Shayshez/1uO_c-4ROBOTS/README.md

# 1uO_c-4ROBOTS
1u Ornament and Crime for Intellijel 1u format

Firmware with VOR Support Available here:

https://www.plum-audio.com/firmwares
