Shayshez/1uO_c-4ROBOTS/BOM.xlsx

Sheet: MAIN BOARD
Qty | Value | Device | Package | Parts | Mouser part# | Description | ARROW_PART_NUMBER | ARROW_PRICE-STOCK | AVAILABILITY | DESCRIPTION | HEIGHT | MANUFACTURER_NAME | MANUFACTURER_PART_NUMBER | MF | MP | MPN | PACKAGE | PRICE | RS_PART_NUMBER | RS_PRICE-STOCK | SPICEPREFIX | VALUE | WE-NUMBER
 | Resistors
6 | 100R | R-EU_R0603 | R0603 | R1, R4, R8, R15, R42, R43 | 71-CRCW0603100RFKEAC | RESISTOR, European symbol |  |  |  |  |  |  |  |  |  |  |  |  |  |  | R
4 | 220R | R-EU_R0603 | R0603 | R33, R35, R36, R38 | 279-CRGCQ0603F220R | RESISTOR, European symbol |  |  |  |  |  |  |  |  |  |  |  |  |  |  | R
1 | 2K | R-EU_R0603 | R0603 | R25 | 652-CR0603-FX2001EPF | RESISTOR, European symbol |  |  |  |  |  |  |  |  |  |  |  |  |  |  | R
2 | 10k | R-EU_R0603 | R0603 | R40, R41 | 279-CRGP0603F10K | RESISTOR, European symbol |  |  |  |  |  |  |  |  |  |  |  |  |  |  | R
4 | 24K | R-EU_R0603 | R0603 | R26, R27, R28, R29 | 667-ERJ-3EKF2402V | RESISTOR, European symbol |  |  |  |  |  |  |  |  |  |  |  |  |  |  | R
8 | 33K | R-EU_R0603 | R0603 | R2, R5, R11, R14, R18, R19, R21, R24 | 755-SFR03EZPF3302 | RESISTOR, European symbol |  |  |  |  |  |  |  |  |  |  |  |  |  |  | R
5 | 75K | R-EU_R0603 | R0603 | R6, R9, R12, R16, R31 | 667-ERJ-3EKF7502V | RESISTOR, European symbol |  |  |  |  |  |  |  |  |  |  |  |  |  |  | R
13 | 100K | R-EU_R0603 | R0603 | R3, R7, R10, R13, R17, R20, R22, R23, R30 R32,, R34, R37, R39 | 71-CRCW0603100KFKEAC | RESISTOR, European symbol |  |  |  |  |  |  |  |  |  |  |  |  |  |  | R
 | Caps 0603 >25V
4 | 22p C0G | C-EUC0603 | C0603 | C24, C25, C28, C30 | 581-06035A220JAT4A | CAPACITOR, European symbol
4 | 560p C0G | C-EUC0603 | C0603 | C1, C2, C4, C6 | 581-06035A561JAT4A | CAPACITOR, European symbol
13 | 100n | C-EUC0603 | C0603 | C3, C5, C9, C10, C16, C17, C21, C22, C23, C26, C27, C29, C31 | 80-C0603C104Z3V | CAPACITOR, European symbol
1 | 470n | C-EUC0603 | C0603 | C15 | 963-UMK107B7474KA-TR | CAPACITOR, European symbol
2 | 1uF | C-EUC0603 | C0603 | C11, C14 | 810-CGA3E1X7R1E105K | CAPACITOR, European symbol
1 | 10uF > 10V | C-EUC0603 | C0603 | C20 | 81-GRM188R61E106KA3J | CAPACITOR, European symbol
 | Caps 1206
2 | 10uF | C-EUC1206K | C1206K | C7, C8 | 963-TMK316BJ106KL-T | CAPACITOR, European symbol
 | Caps electrolytic
2 | 10uF | CPOL-EUB | PANASONIC_B | C12, C13 | 667-EEE-FK1H100SR | POLARIZED CAPACITOR, European symbol |  |  |  |  |  |  |  |  |  |  |  |  |  |  | C
1 | 10uF | CPOL-USA | PANASONIC_A | C40 | 598-AVE106M16A12T-F | POLARIZED CAPACITOR, American symbol
2 | 22uF | CPOL-EUC | PANASONIC_C | C18, C19 | 667-EEE-FK1H220SR | POLARIZED CAPACITOR, European symbol |  |  |  |  |  |  |  |  |  |  |  |  |  |  | C
 | Inductor
1 | 10uH | WE-LQ_1210_744032001 | WE-LQ_M | L1 | 963-LB3218T100K | SMD Inductor |  |  |  |  |  |  |  |  |  |  |  |  |  |  |  |  | 744032001/1uH
 | IC's
2 | 1N5819HW | DIODE_DIODE-SOD123 | DIODE_SOD123 | D1, D2 | 621-1N5819HW-F | DIODE
1 | ADP150AUJZ-3.3-R7 | ADP150AUJZ-3.3-R7 | SOT95P280X100-5N | U1 | 584-ADP150AUJZ-3.3R7 | IC REG LINEAR 2V 150MA 5TSOT |  |  | Good | LDO Regulator Pos 2V 0.15A 5-Pin TSOT T/R |  |  |  | Analog Devices | ADP150AUJZ-2.0-R7 |  | TSOT-23 Analog Devices | 0.65 USD
1 | DAC8565IAPW | DAC8565IAPW | SOP65P640X120-16N | U3 | 595-DAC8565IAPW | Quad Channel DAC |  |  | Good | 16-Bit, Quad Channel, Ultra-Low Glitch, Voltage Output DAC with 2.5V, 2ppm/C Internal eference 16-TSSOP -40 to 105 |  |  |  | Texas Instruments | DAC8565IAPW |  | TSSOP-16 Texas Instruments | 10.78 USD
1 | LD1117S50TR | LD1117S50TR | SOT223 | U2 | 511-LD1117S50 | http://octopart.com/ld1117s50tr-stmicroelectronics-529395 |  |  | Good | LD1117 Series 1300 mA 5 V Fixed Output Positive Voltage LDO Regulator - SOT-223 |  |  |  | STMicroelectronics | LD1117S50TR |  | SOT-223 STMicroelectronics | 0.19 USD
1 | LM321MF | LM321MF | SOT23-5 | IC7 | 926-LM321MF | Low Power Single Op Amp
1 | LM4040-5V | LM4041B12DBZ | DBZ_R-PDSO-G3 | IC3 | 926-LM4040DIM350NOPB | PRECISION MICROPOWER SHUNT VOLTAGE REFERENCE
2 | MCP6002SMT | MCP6002SMT | SOIC8 | IC1, IC2 | 579-MCP6002T-I/SN | Dual General Op Amp
1 | MIC803-46D2VM3TR | MIC803-46D2VM3TR | SOT95P230X110-3N | IC4 | 998-MIC803-26D2VM3TR | 3-pin Microprocessor Supervosor Circui | MIC803-46D2VM3TR |  |  | 3-pin Microprocessor Supervosor Circui | mm | Micrel | MIC803-46D2VM3TR
4 | MMBT3904LT1G | SMD-TRANSISTORS-NPN-40V-200MA-MMBT3904LT1G(SOT-23) | SOT-23 | Q1, Q2, Q3, Q4 | 863-MMBT3904LT1G | 305010013 |  |  |  |  |  |  |  |  |  | MMBT3904LT1G |  |  |  |  |  | MMBT3904LT1G
2 | TL072D | TL072D | SO08 | IC5, IC6 | 595-TL072CDR | OP AMP
1 | TEENSY_3.2_TEMPS_NO29 | TEENSY_3.2_TEMPS_NO29 | TEENSY_3.2_TEMPS_NO29 | TEENSY | 474-DEV-13736
 | PIN HEADERS MALE
1 | POWER Header | PINHD-2X5 | 2X5 | Power
1 |  | PINHD-2X5 | 2X5 | J3 |  | WR-PHD 2.54mm Dual Pin Header, 10 Pins =>Code : Con_BTB_PHD_2.54_2_61301021121
3 |  | PINHD-1X4 | 1X04 | J2, J4, J5 |  | PIN HEADER
1 |  | PINHD-1X8 | 1X08 | J1 |  | PIN HEADER

Sheet: UI BOARD
Qty | Value | Device | Package | Parts |  | Description | SPICEPREFIX
 | Resistor 0603
2 | 510R | R-EU_R0603 | R0603 | R100, R101 | 603-RC0603FR-07510RL | RESISTOR, European symbol | R
1 | 10k | R-EU_R0603 | R0603 | R102 | 279-CRGP0603F10K | RESISTOR, European symbol | R
 | Caps 0603
3 | 100n | C-EUC0603 | C0603 | C101, C103, C104 | 80-C0603C104Z3V | CAPACITOR, European symbol
2 | 470n | C-EUC0603 | C0603 | C100, C102 | 963-UMK107B7474KA-TR | CAPACITOR, European symbol
 | UI Parts
12 | PJ301_PJ301 (THONKICONN) | PJ301_PJ301 | PJ301_WQP_PJ_301M6 | CV1, CV2, CV3, CV4, CV_A, CV_B, CV_C, CV_D, TR1, TR2, TR3, TR4 | Thonk
2 | PEC11RPEC11R-SLOTED | PEC11RPEC11R-SLOTED | PEC11R-SLOTED | ENC_L, ENC_R | 858-EN11-HSM1BF20 | Incremental encoder 24 detents 24 pulses Bourns 24 Pulse Incremental Mechanical Rotary Encoder with a 6 mm Flat Shaft (Not Indexed), Through Hole
2 | Tact Switch | TAC_SWITCHPTH | TACTILE-PTH | SW_B, SW_T | 612-TL1105SP-250 | Momentary Switch
2 | Tact Switch CAP |  |  |  | 612-1R-BK
1 | 0.96_OLED_BOARD | 0.96_OLED_BOARD | 0.96_OLED_BOARD | OLED
 | PIN HEADERS FEMALE
1 |  | PINHD-2X5 | 2X5 | J102 |  | WR-PHD 2.54mm Dual Pin Header, 10 Pins =>Code : Con_BTB_PHD_2.54_2_61301021121
3 |  | PINHD-1X4 | 1X04 | J100, J103, J104 |  | PIN HEADER
1 |  | PINHD-1X8 | 1X08 | J101 |  | PIN HEADER

Sheet: 0.96 OLED BOARD
Qty | Value | Device | Package | Parts |  | Description | SPICEPREFIX
 | Resistors 0603
4 | 10K | RESISTOR0603MINI | 0603-MINI | R2, R4, R5, R6 | 279-CRGP0603F10K | Resistors
1 | 390K | RESISTOR0603MINI | 0603-MINI | R3 | 603-RC0603FR-07390KL | Resistors
 | Caps 0603
5 | 2.2uF | CAP_CERAMIC0603MINI | 0603-MINI | C3, C4, C6, C7, C8 | 963-EMK107BJ225MA-T | Ceramic Capacitors
1 | 10uF | CAP_CERAMIC0603MINI | 0603-MINI | C5 | 81-GRM188R61E106KA3J | Ceramic Capacitors
1 | UG-2864HSWEG01 | MICROBUILDER_DISP_OLED_UG-2864HSWEG010.96";MICROBUILDER_UG-2864HSWEG01_0.96IN_WRAPAROUND" | U1 | UG-2864HSWEG01 OLED display
1 |  | HEADER-1X7ROUND | 1X07_ROUND | JP1 |  | PIN HEADER | X
3 | Standoffs spacers 6mm | To support screen
