Shayshez/1uO_c-4ROBOTS/4robots_MAIN_1_1.brd

## EAGLE design 4robots_MAIN_1_1.brd (2019-09-29)

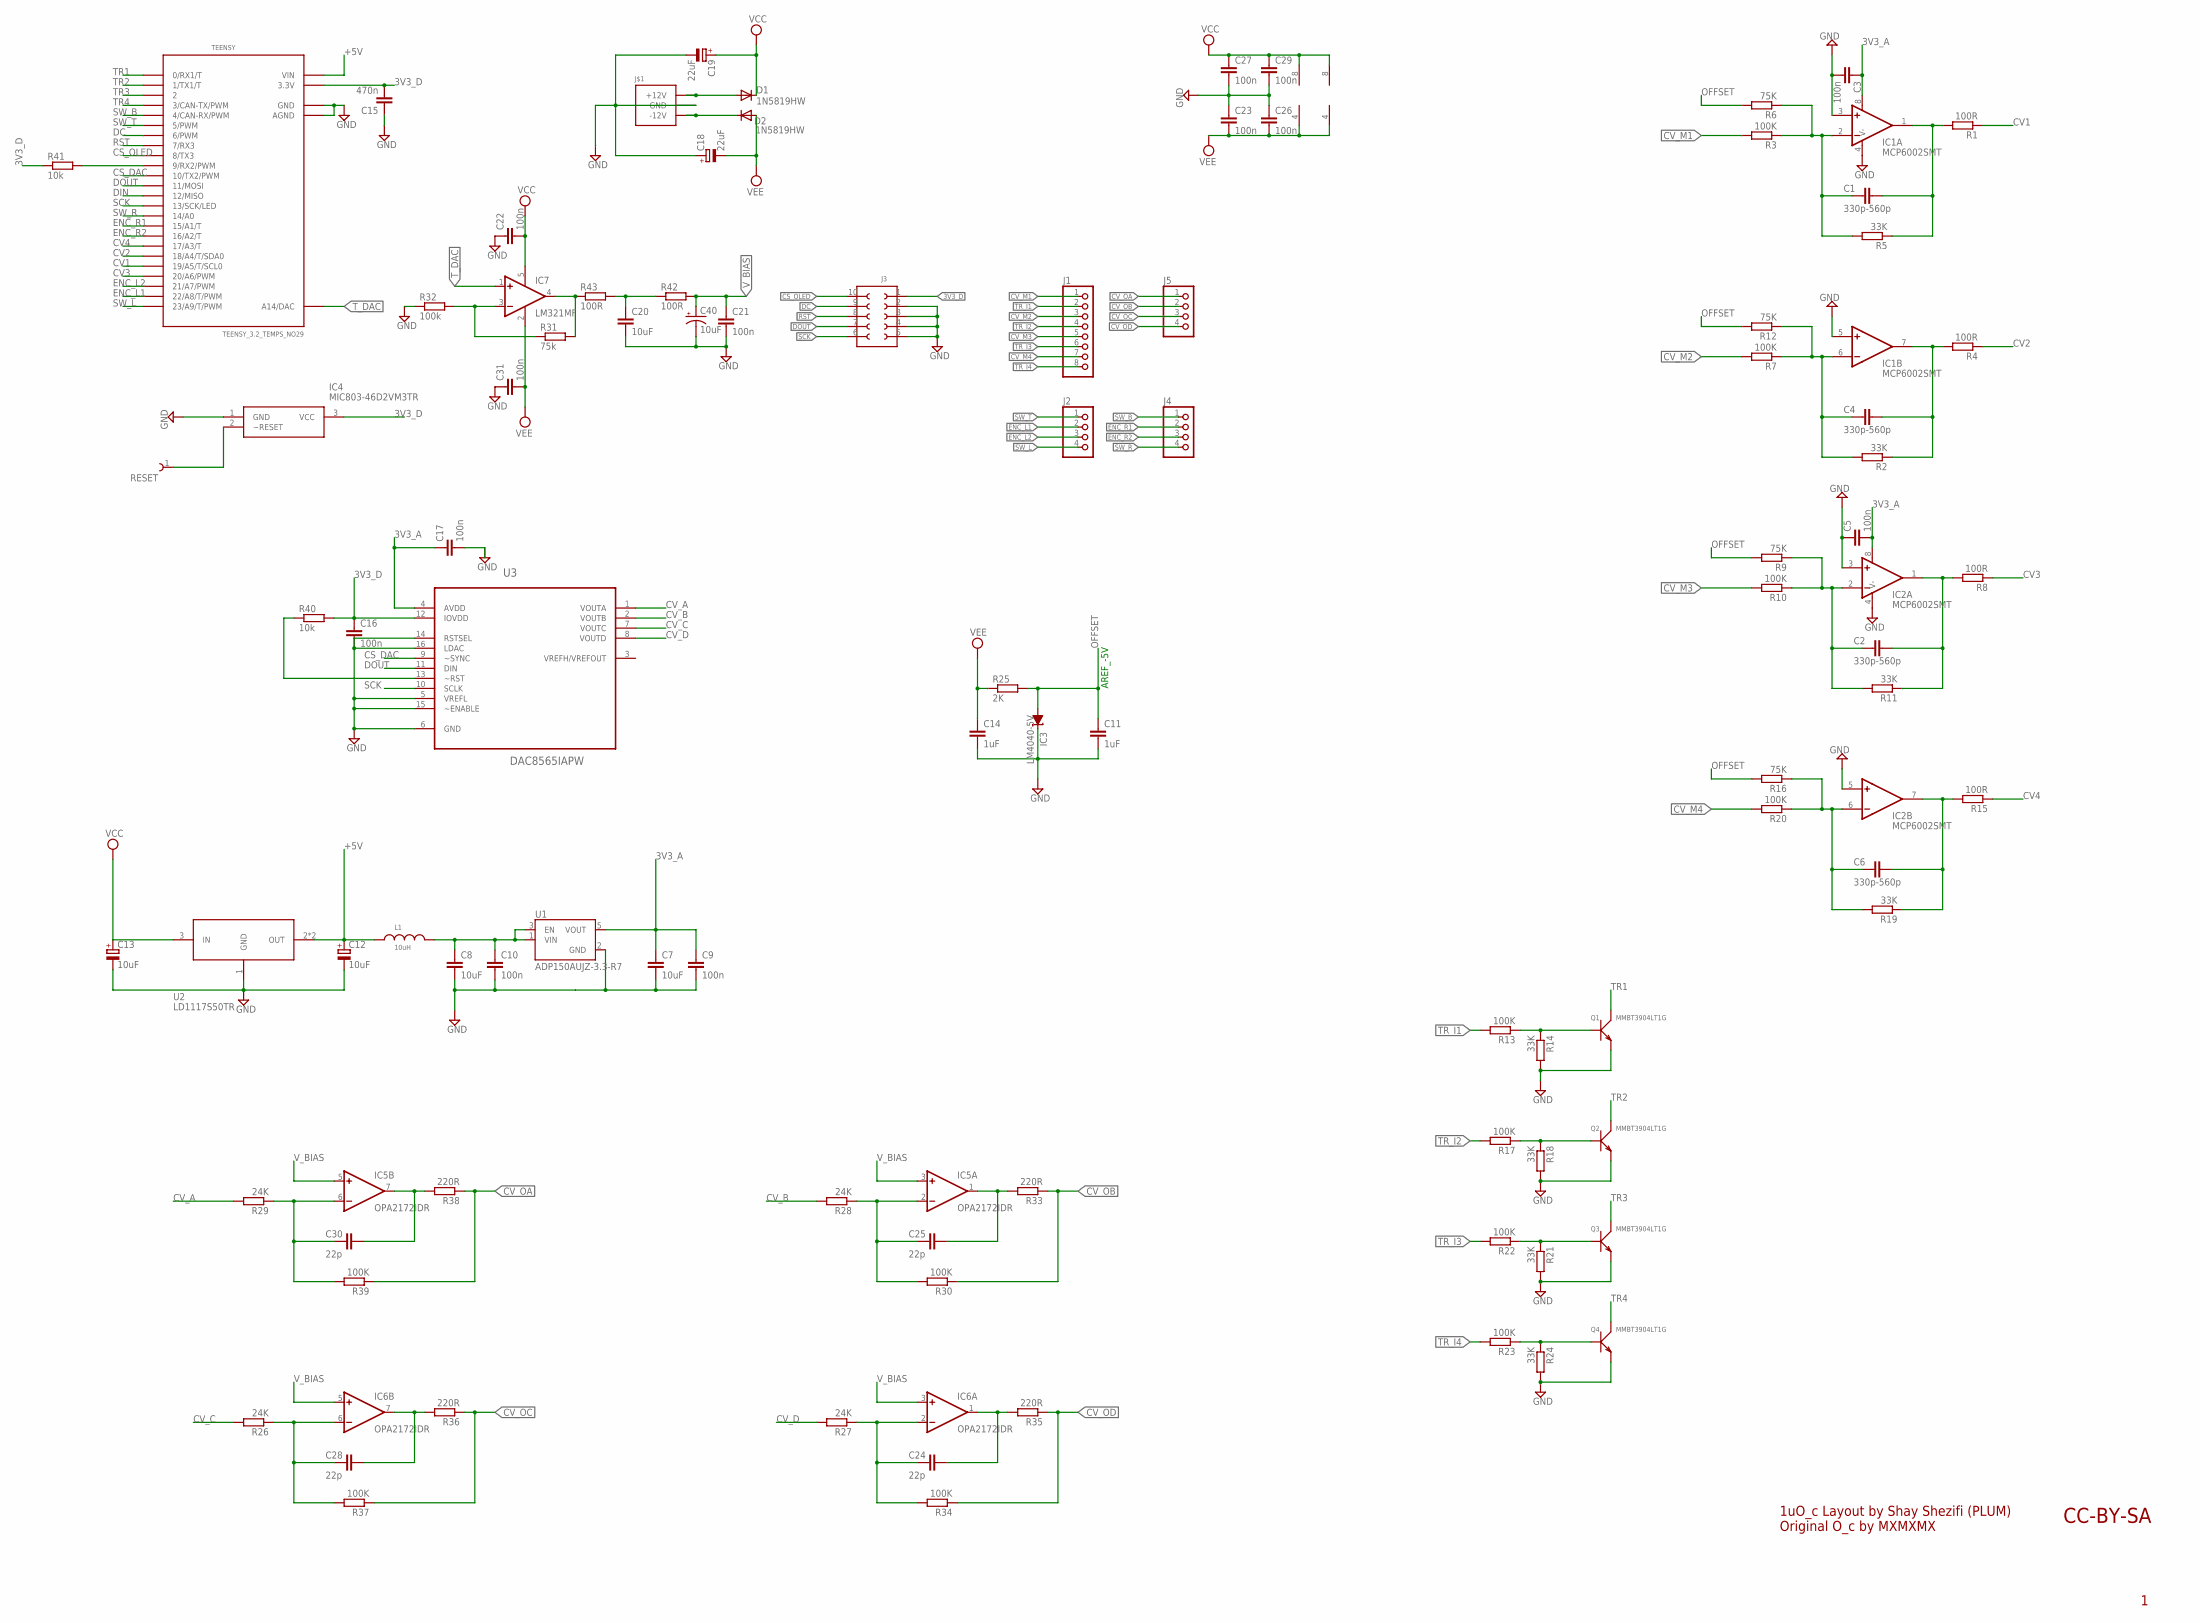
[picture p1: schematic 4robots_MAIN_1_1.sch]

Parts:
C1, C2, C4, C6: 330p-560p; C0603
C3, C5, C9, C10, C16, C17, C21, C22, C23, C26, C27, C29, C31: 100n; C0603
C7, C8: 10uF; C1206K
C11, C14: 1uF; C0603
C12, C13: 10uF; PANASONIC_B
C15: 470n; C0603
C18, C19: 22uF; PANASONIC_C
C20: 10uF; C0603
C24, C25, C28, C30: 22p; C0603
C40: 10uF; PANASONIC_A
D1, D2: 1N5819HW; DIODE_SOD123
IC1, IC2: MCP6002SMT; SOIC8
IC3: LM4040-5V; DBZ_R-PDSO-G3
IC4: MIC803-46D2VM3TR; SOT95P230X110-3N
IC5, IC6: OPA2172IDR; SO08
IC7: LM321MF; SOT23-5
J1: PINHD-1X8; 1X08
J2, J4, J5: PINHD-1X4; 1X04
J3: 61301021121
J$1: POWER_SIMPLE10; POWER_10
L1: 10uH; WE-LQ_M
Q1, Q2, Q3, Q4: MMBT3904LT1G; SOT-23
R1, R4, R8, R15, R42, R43: 100R; R0603
R2, R5, R11, R14, R18, R19, R21, R24: 33K; R0603
R3, R7, R10, R13, R17, R20, R22, R23, R30, R34, R37, R39: 100K; R0603
R6, R9, R12, R16: 75K; R0603
R25: 2K; R0603
R26, R27, R28, R29: 24K; R0603
R31: 75k; R0603
R32: 100k; R0603
R33, R35, R36, R38: 220R; R0603
R40, R41: 10k; R0603
RESET: 61300111121
TEENSY: TEENSY_3.2_TEMPS_NO29
U1: ADP150AUJZ-3.3-R7; SOT95P280X100-5N
U2: LD1117S50TR; SOT223
U3: DAC8565IAPW; SOP65P640X120-16N

Connections:
3V3_A: C3.1, C5.2, C7.1, C9.1, C17.1, IC1.8 (V+), IC2.8 (V+), U1.5 (VOUT), U3.4 (AVDD)
3V3_D: C15.2, C16.1, IC4.3 (VCC), J3.1, R40.2, R41.1, TEENSY.3.3V, U3.12 (IOVDD)
+5V: C12.+, L1.1, TEENSY.VIN, U2.2 (OUT), U2.4 (OUT)
CS_DAC: TEENSY.10 (10/TX2/PWM), U3.9 (~SYNC)
CS_OLED: J3.10, TEENSY.8 (8/TX3)
CV1: R1.1, TEENSY.19/A5 (19/A5/T/SCL0)
CV2: R4.1, TEENSY.18/A4 (18/A4/T/SDA0)
CV3: R8.1, TEENSY.20/A6 (20/A6/PWM)
CV4: R15.1, TEENSY.17/A3 (17/A3/T)
CV_A: R29.2, U3.1 (VOUTA)
CV_B: R28.2, U3.2 (VOUTB)
CV_C: R26.2, U3.7 (VOUTC)
CV_D: R27.2, U3.8 (VOUTD)
CV_M1: J1.1, R3.2
CV_M2: J1.3, R7.2
CV_M3: J1.5, R10.2
CV_M4: J1.7, R20.2
CV_OA: J5.1, R38.1, R39.1
CV_OB: J5.2, R30.1, R33.1
CV_OC: J5.3, R36.1, R37.1
CV_OD: J5.4, R34.1, R35.1
DC: J3.9, TEENSY.6 (6/PWM)
DIN: TEENSY.12 (12/MISO)
DOUT: J3.7, TEENSY.11 (11/MOSI), U3.11 (DIN)
ENC_L1: J2.2, TEENSY.22/A8 (22/A8/T/PWM)
ENC_L2: J2.3, TEENSY.21/A7 (21/A7/PWM)
ENC_R1: J4.2, TEENSY.15/A1 (15/A1/T)
ENC_R2: J4.3, TEENSY.16/A2 (16/A2/T)
GND: C3.2, C5.1, C7.2, C8.2, C9.2, C10.2, C11.2, C12.-, C13.-, C14.2, C15.1, C16.2, C17.2, C18.+, C19.-, C20.2, C21.2, C22.1, C23.1, C26.1, C27.2, C29.2, C31.1, C40.-, IC1.3 (+IN), IC1.4 (V-), IC1.5 (+IN), IC2.3 (+IN), IC2.4 (V-), IC2.5 (+IN), IC3.1 (C), IC4.1 (GND), J3.2, J3.3, J3.4, J3.5, J$1.3 (GND), J$1.4 (GND), J$1.5 (GND), J$1.6 (GND), J$1.7 (GND), J$1.8 (GND), Q1.2 (E), Q2.2 (E), Q3.2 (E), Q4.2 (E), R14.2, R18.2, R21.2, R24.2, R32.1, TEENSY.AGND, TEENSY.GND, U1.2 (GND), U2.1 (GND), U3.5 (VREFL), U3.6 (GND), U3.14 (RSTSEL), U3.15 (~ENABLE), U3.16 (LDAC)
unnamed: D2.C, J$1.1 (-12V), J$1.2 (-12V)
unnamed: D1.A, J$1.9 (+12V), J$1.10 (+12V)
unnamed: C8.1, C10.1, L1.2, U1.1 (VIN), U1.3 (EN)
unnamed: IC7.4 (OUT), R31.2, R43.1
unnamed: C1.2, IC1.2 (-IN), R3.1, R5.2, R6.1
unnamed: C1.1, IC1.1 (OUT), R1.2, R5.1
unnamed: IC7.3 (-IN), R31.1, R32.2
unnamed: R40.1, U3.13 (~RST)
unnamed: R41.2, TEENSY.9 (9/RX2/PWM)
unnamed: C4.2, IC1.6 (-IN), R2.2, R7.1, R12.1
unnamed: C4.1, IC1.7 (OUT), R2.1, R4.2
unnamed: C20.1, R42.1, R43.2
unnamed: C2.2, IC2.2 (-IN), R9.1, R10.1, R11.2
unnamed: C2.1, IC2.1 (OUT), R8.2, R11.1
unnamed: C6.2, IC2.6 (-IN), R16.1, R19.2, R20.1
unnamed: C6.1, IC2.7 (OUT), R15.2, R19.1
unnamed: Q1.1 (B), R13.1, R14.1
unnamed: Q2.1 (B), R17.1, R18.1
unnamed: Q3.1 (B), R21.1, R22.1
unnamed: Q4.1 (B), R23.1, R24.1
unnamed: C25.2, IC5.2 (-IN), R28.1, R30.2
unnamed: C30.2, IC5.6 (-IN), R29.1, R39.2
unnamed: C30.1, IC5.7 (OUT), R38.2
unnamed: C25.1, IC5.1 (OUT), R33.2
unnamed: C28.2, IC6.6 (-IN), R26.1, R37.2
unnamed: C28.1, IC6.7 (OUT), R36.2
unnamed: C24.2, IC6.2 (-IN), R27.1, R34.2
unnamed: C24.1, IC6.1 (OUT), R35.2
unnamed: IC4.2 (~RESET), RESET.1
OFFSET: C11.1, IC3.2 (A), R6.2, R9.2, R12.2, R16.2, R25.2
RST: J3.8, TEENSY.7 (7/RX3)
SCK: J3.6, TEENSY.13 (13/SCK/LED), U3.10 (SCLK)
SW_B: J4.1, TEENSY.4 (4/CAN-RX/PWM)
SW_L: J2.4, TEENSY.23/A9 (23/A9/T/PWM)
SW_R: J4.4, TEENSY.14/A0
SW_T: J2.1, TEENSY.5 (5/PWM)
TR1: Q1.3 (C), TEENSY.0 (0/RX1/T)
TR2: Q2.3 (C), TEENSY.1 (1/TX1/T)
TR3: Q3.3 (C), TEENSY.2
TR4: Q4.3 (C), TEENSY.3 (3/CAN-TX/PWM)
TR_I1: J1.2, R13.2
TR_I2: J1.4, R17.2
TR_I3: J1.6, R22.2
TR_I4: J1.8, R23.2
T_DAC: IC7.1 (+IN), TEENSY.RESET/DAC (A14/DAC)
VCC: C13.+, C19.+, C22.2, C27.1, C29.1, D1.C, IC5.8 (V+), IC6.8 (V+), IC7.5 (V+), U2.3 (IN)
VEE: C14.1, C18.-, C23.2, C26.2, C31.2, D2.A, IC5.4 (V-), IC6.4 (V-), IC7.2 (V-), R25.1
V_BIAS: C21.1, C40.+, IC5.3 (+IN), IC5.5 (+IN), IC6.3 (+IN), IC6.5 (+IN), R42.2

Notes on the sheet:
AREF_-5V
1uO_c Layout by Shay Shezifi (PLUM) Original O_c by MXMXMX
CC-BY-SA

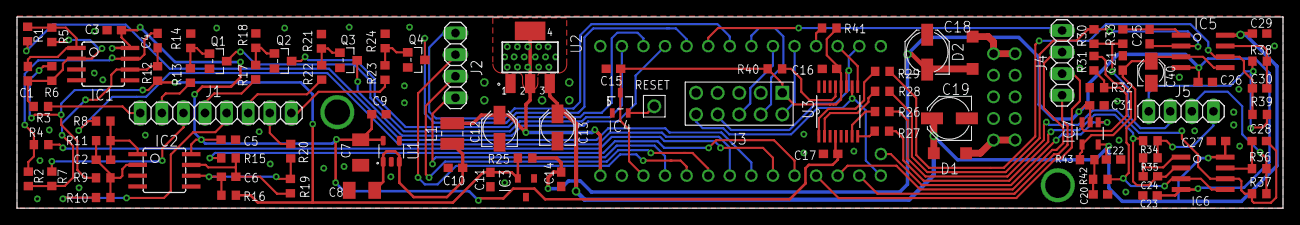
[picture p2: board 4robots_MAIN_1_1.brd from above]

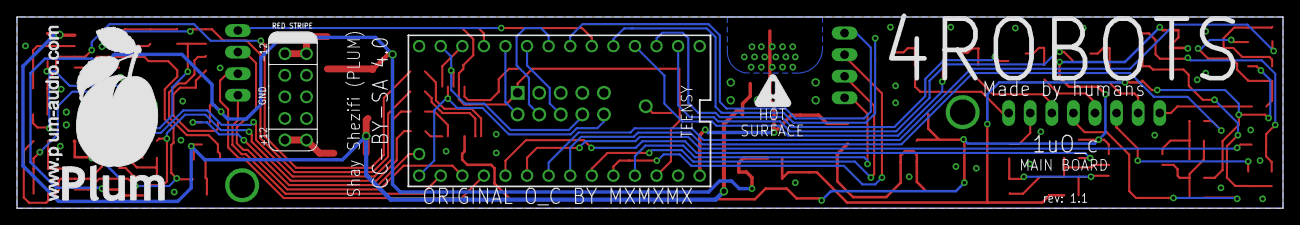
[picture p3: board 4robots_MAIN_1_1.brd from below]

Board: 2 copper layers, 149.0 x 22.5 mm, 100 parts (2 on the bottom side), 76 nets.
