Shayshez/1uO_c-4ROBOTS/0_96_OLED_FOR_1U.brd

## EAGLE design 0_96_OLED_FOR_1U.brd (2019-09-29)

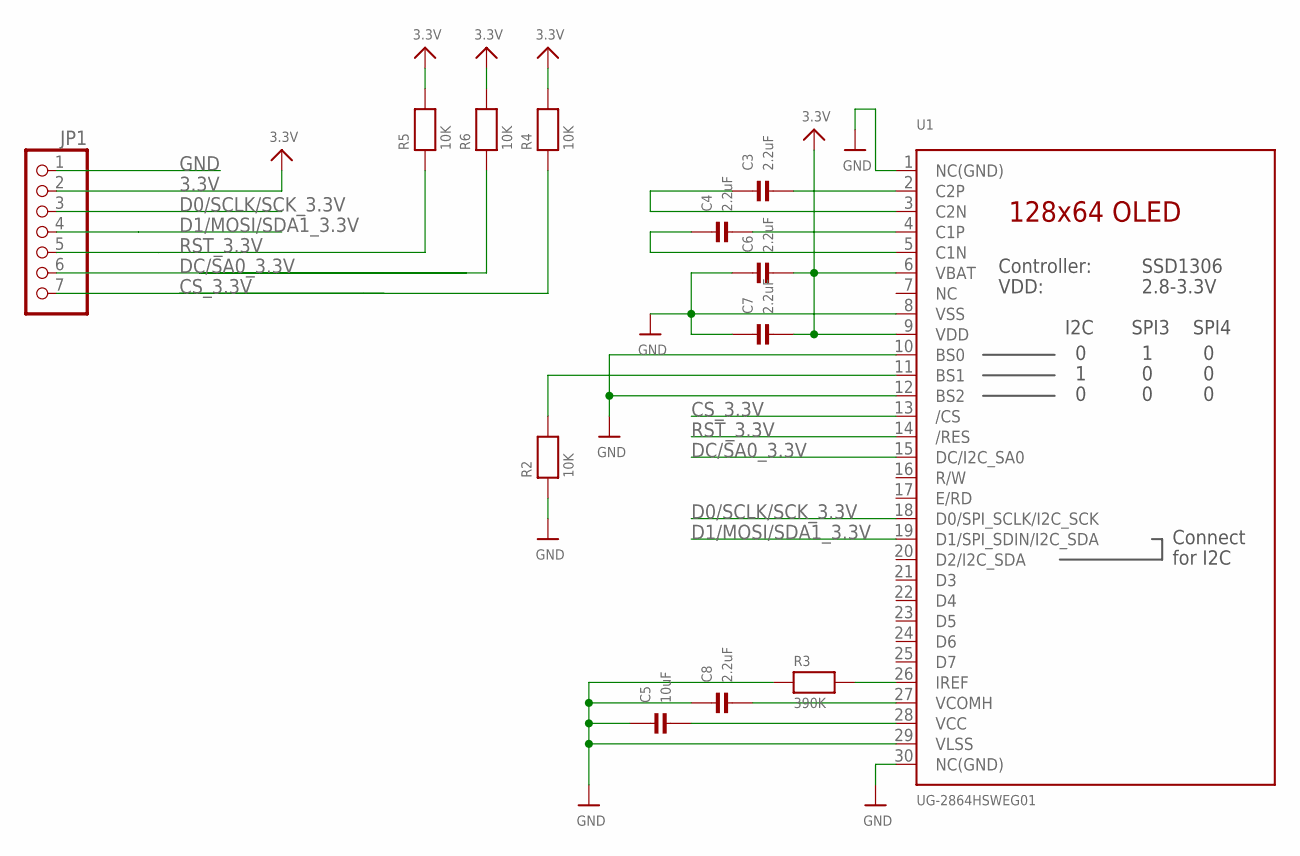
[picture p4: schematic 0_96_OLED_FOR_1U.sch]

Parts:
C3, C4, C6, C7, C8: 2.2uF; 0603-MINI
C5: 10uF; 0603-MINI
JP1: HEADER-1X7ROUND; 1X07_ROUND
R2, R4, R5, R6: 10K; 0603-MINI
R3: 390K; 0603-MINI
U1: UG-2864HSWEG01; MICROBUILDER_UG-2864HSWEG01_0.96IN_WRAPAROUND

Connections:
3.3V: C6.2, C7.2, JP1.2, R4.2, R5.2, R6.2, U1.6 (VBAT), U1.9 (VDD)
CS_3.3V: JP1.7, R4.1, U1.13 (/CS)
D0/SCLK/SCK_3.3V: JP1.3, U1.18 (D0/SPI_SCLK/I2C_SCK)
D1/MOSI/SDA1_3.3V: JP1.4, U1.19 (D1/SPI_SDIN/I2C_SDA)
DC/SA0_3.3V: JP1.6, R6.1, U1.15 (DC/I2C_SA0)
GND: C5.1, C6.1, C7.1, C8.1, JP1.1, R2.1, R3.1, U1.1 (NC(GND)), U1.8 (VSS), U1.10 (BS0), U1.12 (BS2), U1.29 (VLSS), U1.30 (NC(GND))
unnamed: R2.2, U1.11 (BS1)
unnamed: R3.2, U1.26 (IREF)
unnamed: C3.2, U1.2 (C2P)
unnamed: C3.1, U1.3 (C2N)
unnamed: C4.2, U1.4 (C1P)
unnamed: C4.1, U1.5 (C1N)
unnamed: C5.2, U1.28 (VCC)
unnamed: C8.2, U1.27 (VCOMH)
RST_3.3V: JP1.5, R5.1, U1.14 (/RES)

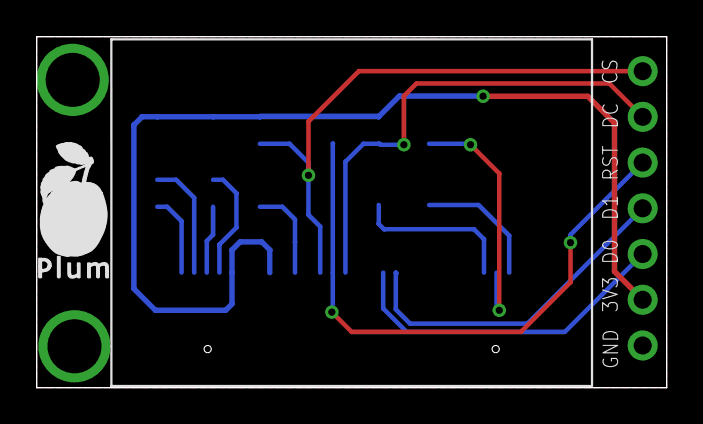
[picture p5: board 0_96_OLED_FOR_1U.brd from above]

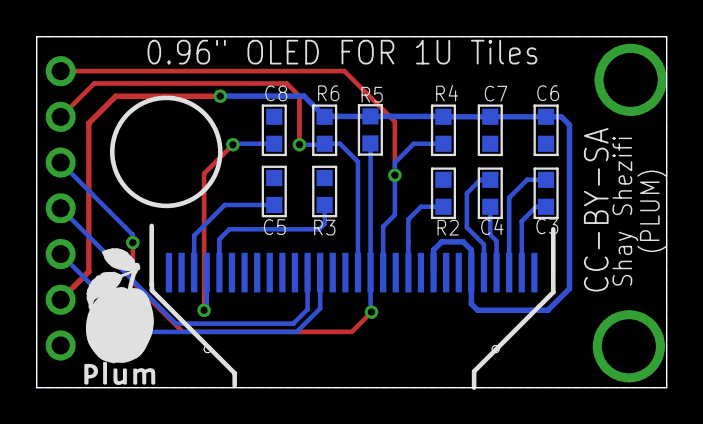
[picture p6: board 0_96_OLED_FOR_1U.brd from below]

Board: 2 copper layers, 35.0 x 19.5 mm, 13 parts (11 on the bottom side), 15 nets.
