Shayshez/1uO_c-4ROBOTS/4ROBOTS_UI_v_1_1.brd

## EAGLE design 4ROBOTS_UI_v_1_1.brd (2019-09-29)

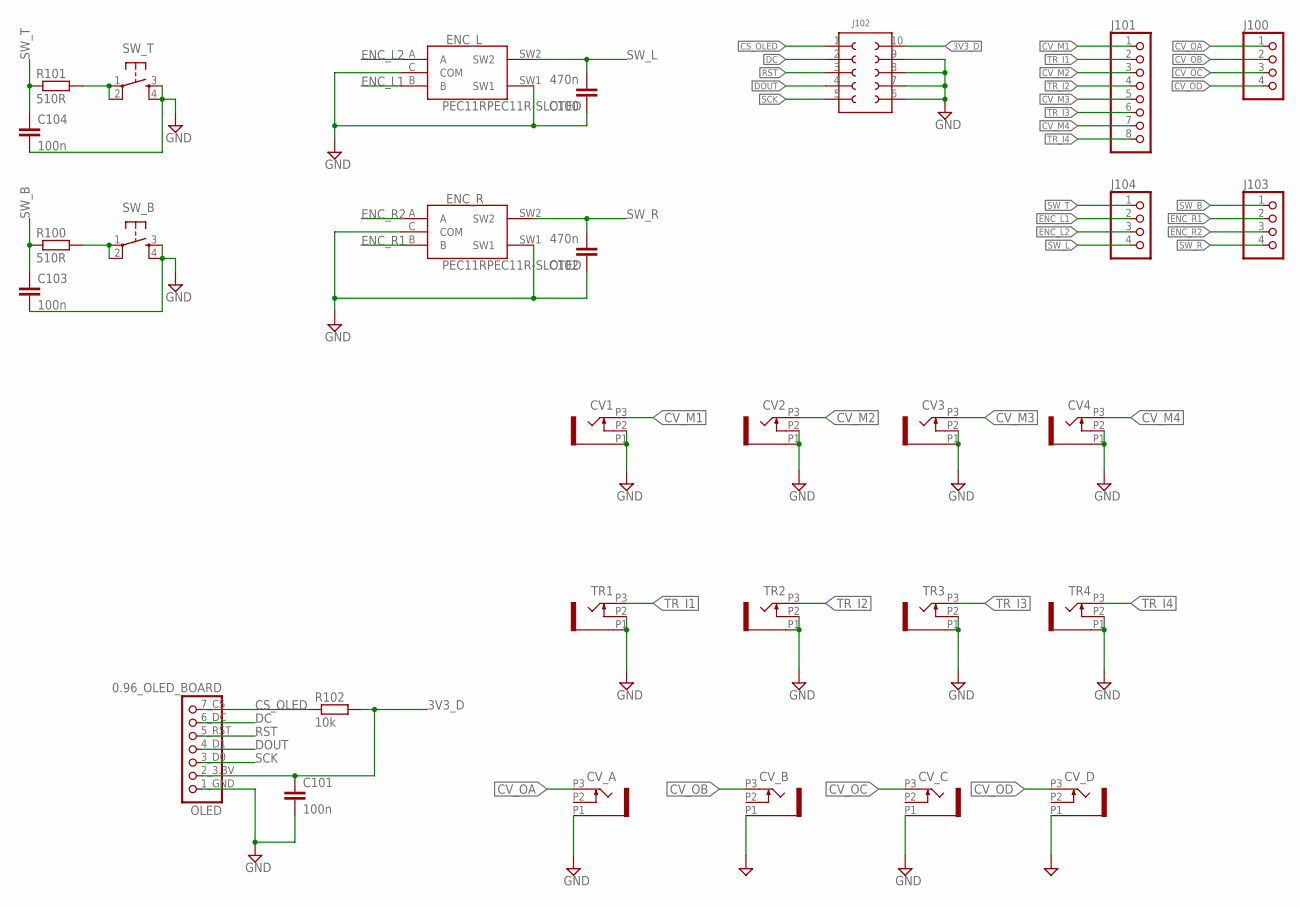
[picture p7: schematic 4ROBOTS_UI_v_1_1.sch]

Parts:
C100, C102: 470n; C0603
C101, C103, C104: 100n; C0603
CV1, CV2, CV3, CV4: OG-PJ301_PJ301_THONKICONN6; OG-PJ301_WQP_PJ_301M6
CV_A: OG-PJ301_PJ301_THONKICONN6; OG-PJ301_WQP_PJ_301M6
CV_B: OG-PJ301_PJ301_THONKICONN6; OG-PJ301_WQP_PJ_301M6
CV_C: OG-PJ301_PJ301_THONKICONN6; OG-PJ301_WQP_PJ_301M6
CV_D: OG-PJ301_PJ301_THONKICONN6; OG-PJ301_WQP_PJ_301M6
ENC_L: PEC11RPEC11R-SLOTED; PEC11R-SLOTED
ENC_R: PEC11RPEC11R-SLOTED; PEC11R-SLOTED
J100, J103, J104: PINHD-1X4; 1X04
J101: PINHD-1X8; 1X08
J102: 61301021121
OLED: 0.96_OLED_BOARD
R100, R101: 510R; R0603
R102: 10k; R0603
SW_B: TAC_SWITCHPTH; TACTILE-PTH
SW_T: TAC_SWITCHPTH; TACTILE-PTH
TR1, TR2, TR3, TR4: OG-PJ301_PJ301_THONKICONN6; OG-PJ301_WQP_PJ_301M6

Connections:
3V3_D: C101.1, J102.10, OLED.2_3.3V (3V3), R102.2
CS_OLED: J102.1, OLED.7_CS (CS), R102.1
CV_M1: CV1.P3 (3), J101.1
CV_M2: CV2.P3 (3), J101.3
CV_M3: CV3.P3 (3), J101.5
CV_M4: CV4.P3 (3), J101.7
CV_OA: CV_A.P3 (3), J100.1
CV_OB: CV_B.P3 (3), J100.2
CV_OC: CV_C.P3 (3), J100.3
CV_OD: CV_D.P3 (3), J100.4
DC: J102.2, OLED.6_DC (DC)
DOUT: J102.4, OLED.4_D1 (D1)
ENC_L1: ENC_L.B, J104.2
ENC_L2: ENC_L.A, J104.3
ENC_R1: ENC_R.B, J103.2
ENC_R2: ENC_R.A, J103.3
GND: C100.1, C101.2, C102.1, C103.2, C104.2, CV1.P1 (1), CV1.P2 (2), CV2.P1 (1), CV2.P2 (2), CV3.P1 (1), CV3.P2 (2), CV4.P1 (1), CV4.P2 (2), CV_A.P1 (1), CV_B.P1 (1), CV_C.P1 (1), CV_D.P1 (1), ENC_L.C (COM), ENC_L.SW1, ENC_R.C (COM), ENC_R.SW1, J102.6, J102.7, J102.8, J102.9, OLED.1_GND (GND), SW_B.3, SW_B.4, SW_T.3, SW_T.4, TR1.P1 (1), TR1.P2 (2), TR2.P1 (1), TR2.P2 (2), TR3.P1 (1), TR3.P2 (2), TR4.P1 (1), TR4.P2 (2)
unnamed: R101.2, SW_T.1, SW_T.2
unnamed: R100.2, SW_B.1, SW_B.2
RST: J102.3, OLED.5_RST (RST)
SCK: J102.5, OLED.3_D0 (D0)
SW_B: C103.1, J103.1, R100.1
SW_L: C100.2, ENC_L.SW2, J104.4
SW_R: C102.2, ENC_R.SW2, J103.4
SW_T: C104.1, J104.1, R101.1
TR_I1: J101.2, TR1.P3 (3)
TR_I2: J101.4, TR2.P3 (3)
TR_I3: J101.6, TR3.P3 (3)
TR_I4: J101.8, TR4.P3 (3)

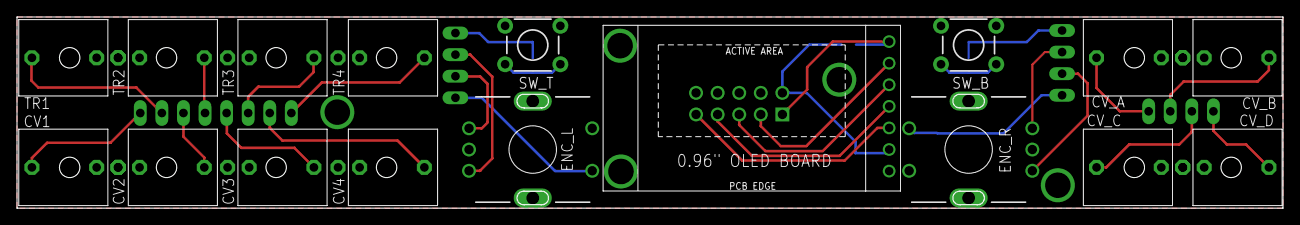
[picture p8: board 4ROBOTS_UI_v_1_1.brd from above]

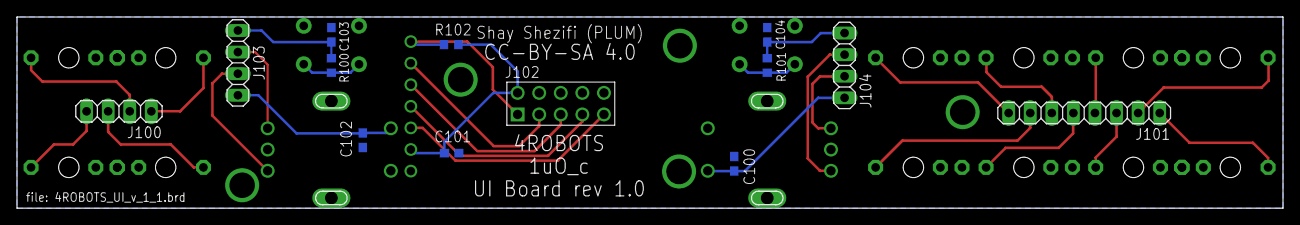
[picture p9: board 4ROBOTS_UI_v_1_1.brd from below]

Board: 2 copper layers, 149.0 x 22.5 mm, 30 parts (13 on the bottom side), 29 nets.
