Shayshez/1uO_c-4ROBOTS/(notices)

Notices in the files:
4ROBOTS_UI_v_1_1.brd:
CC-BY-SA 4.0
parts and their libraries:
Wurth_Elektronik_Electromechanic_Board_t: Copyright: Würth Elektronik
